RaulMoldes/atmega-datalogger/README.md

# atmega-datalogger
Kicad PCB design for a data capture sensor made with ATMEGA328P-AU
