RaulMoldes/atmega-datalogger/(commit log)

2026-01-29 Added symbols to schematic
    [atmega-datalogger.kicad_sch, connectors.kicad_sch]
2026-01-29 Finished schematic
    [atmega-datalogger.kicad_sch, connectors.kicad_sch]
2026-01-29 Terminated schematic
    [atmega-datalogger.kicad_sch]
